sgreg/cookoo-clock/hardware/cookoo-clock/cookoo-clock.pdf

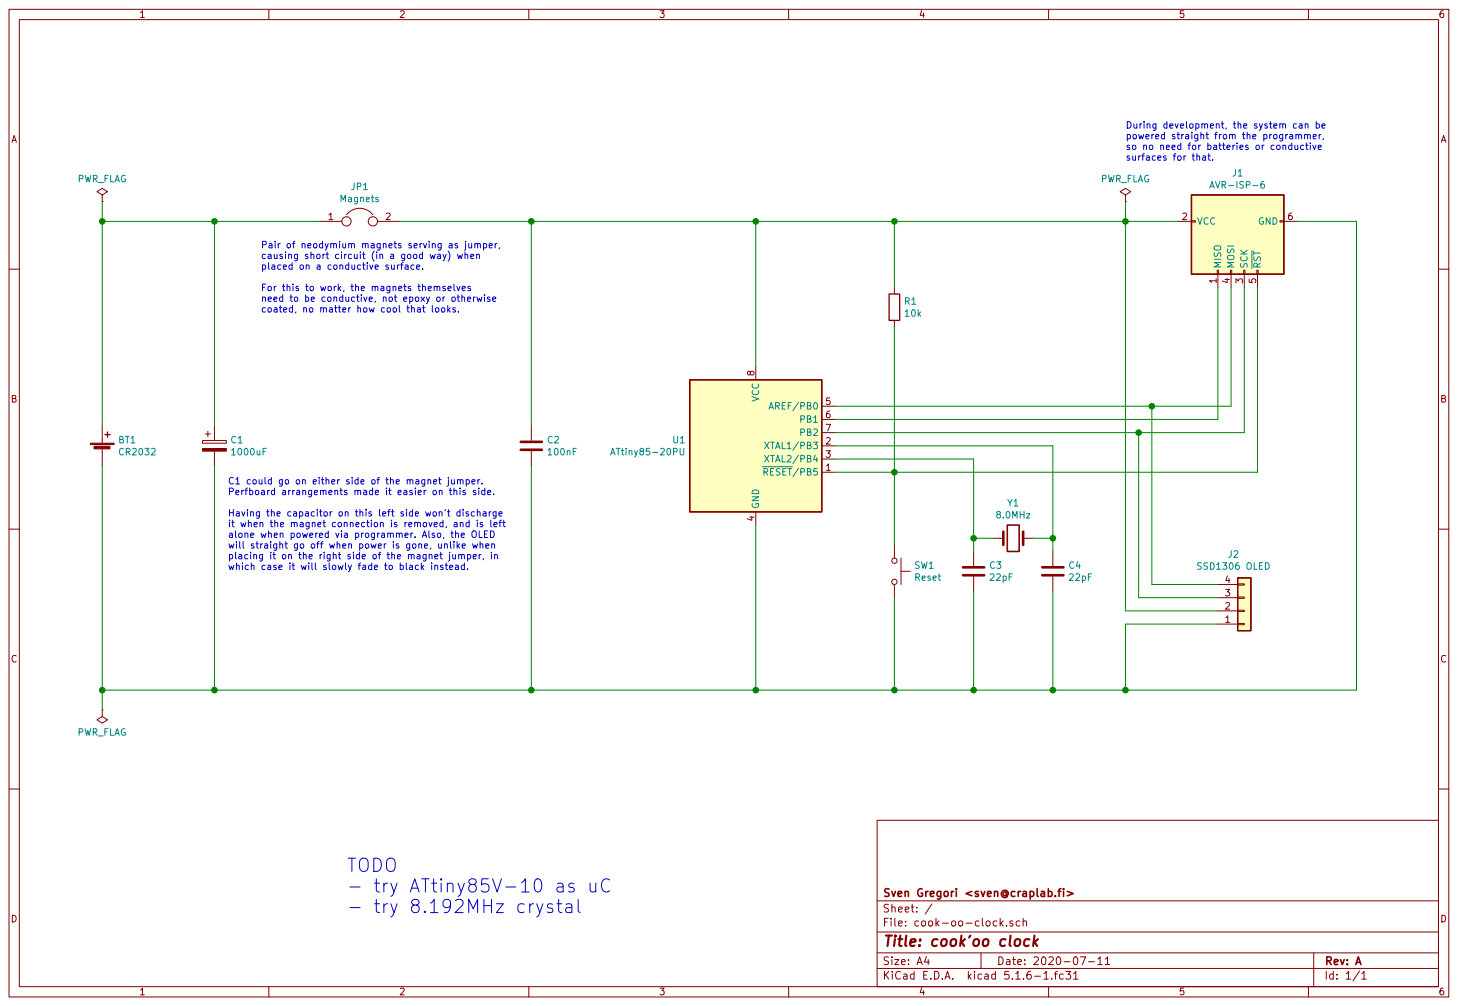
[picture p3: page 1]

During development, the system can be
powered straight from the programmer, so no need for batteries or conductive

coated, no matter how cool that looks. TODO

surfaces for that. Pair of neodymium magnets serving as jumper,

causing short circuit (in a good way) when
placed on a conductive surface.

3 MOSI 4 RST
File: cook-oo-clock.sch Sheet: / Sven Gregori <sven@craplab.fi> C3

For this to work, the magnets themselves
need to be conductive, not epoxy or otherwise

8.0MHz C1 could go on either side of the magnet jumper.
Perfboard arrangements made it easier on this side.

Having the capacitor on this left side won't discharge
it when the magnet connection is removed, and is left
alone when powered via programmer. Also, the OLED
will straight go off when power is gone, unlike when
placing it on the right side of the magnet jumper, in
which case it will slowly fade to black instead.

Id: 1/1 Title: cook'oo clock
