sgreg/cookoo-clock/hardware/cookoo-clock/cookoo-clock.kicad_pcb

## KiCad design el_wire/el_wire.sch

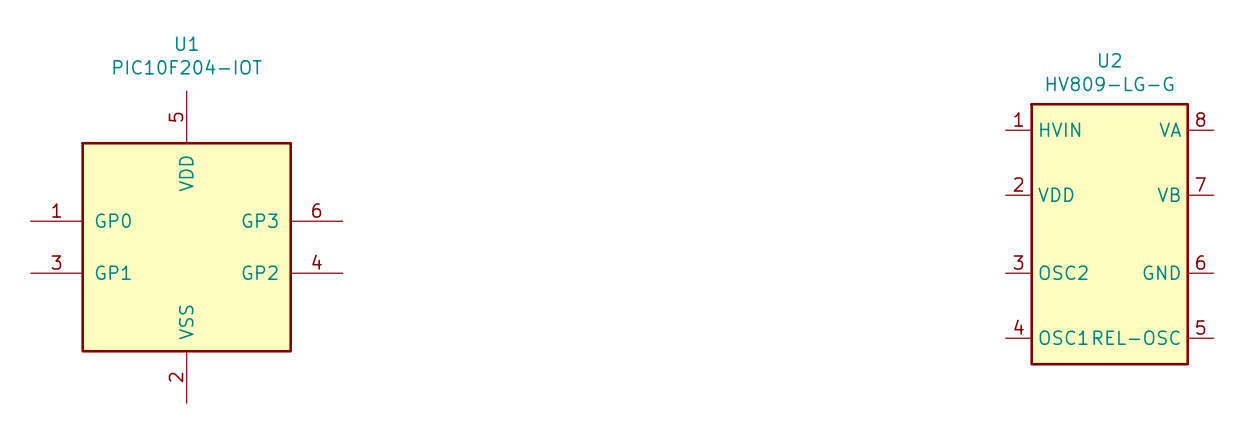
[picture p4: schematic el_wire.sch]

Parts:
U1: PIC10F204-IOT; SOT-23-6
U2: HV809-LG-G; SOIC-8_3.9x4.9mm_P1.27mm
