sgreg/cookoo-clock/(commit log)

2020-08-18 Added section about pre-built ELF/HEX files to README
    To make life easier for people without an AVR GCC tool chain, or the
    time, patience, or interest to set one up, there's a release now that
    contains pre-compiled .elf and .hex files to flash instead.
2020-08-20 Added section about using Arduino as programmer to README
2020-08-20 Added plain avrdude commands as alternative to using make
    Dunno, in case someone doesn't have the whole setup, and doesn't want to
    bother getting it, so all it requires is avrdude and the pre-built .hex
    file. No idea if there's no avrdude either though..
